kheidi/somatoBot/README.md

# somatoBot
For more information view the [report](somatoBot_Presentation.pdf) and [presentation](somatoBot_Report.pdf).

## How to run
To run main somatobot functions upload the somatoBot project (in home directory) to an Arduino Uno.

Schematic can be found in the systemRequirements folder.

## State Machine Demo
To demonstrate the state machine run the project in the stateMachineDemo folder.

## LCD Test
To test the LCD there is a project in the testLCD file.

## Contact
kfehr@wisc.edu & hernandezher@wisc.edu
