kheidi/somatoBot/Notes_Resorces.md

# Project Notes & Resources
## Debug Wire
Used this website: [https://www.hilltop-cottage.info/blogs/adam/debugging-arduino-using-debugwire-atmel-studio-and-an-avr-dragon/](https://www.hilltop-cottage.info/blogs/adam/debugging-arduino-using-debugwire-atmel-studio-and-an-avr-dragon/)

## Motor Control
### PWM Info
#### AVR Timers
- PWM Mode Part 1: https://maxembedded.wordpress.com/2011/08/07/avr-timers-pwm-mode-part-i/
    - Probably want to use Fast PWM on 8 bit 
    - Suggests non-inverted mode
https://maxembedded.com/2012/01/avr-timers-pwm-mode-part-ii/
- Video tutorial on PWM on Mega328p: https://www.youtube.com/watch?v=_7qujfpKyvw
- Notes on PWM Interrupt Codevision: https://students.iitk.ac.in/eclub/assets/lectures/embedded/Embedded-Old-2.pdf
