kheidi/somatoBot/somatoBot_Presentation.pdf

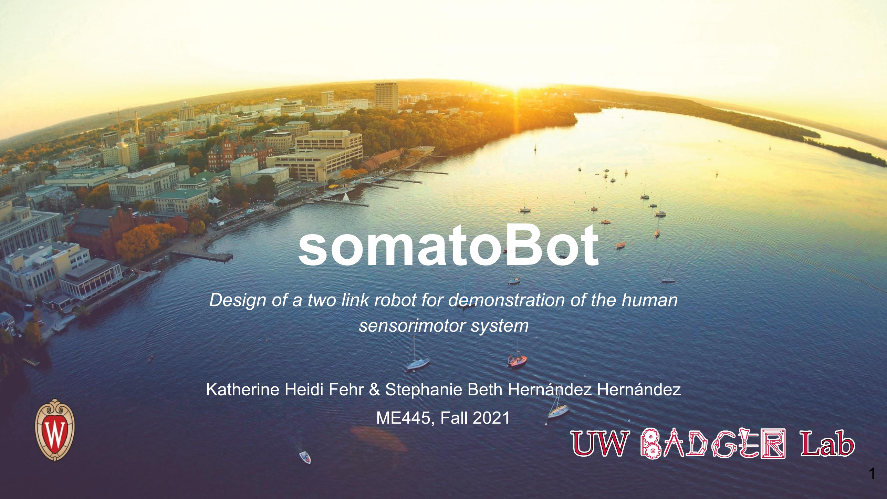
[picture p13: page 1]

# somatoBot

Katherine Heidi Fehr & Stephanie Beth Hernández Hernández

ME445, Fall 2021

Design of a two link robot for demonstration of the human sensorimotor system

## Objective

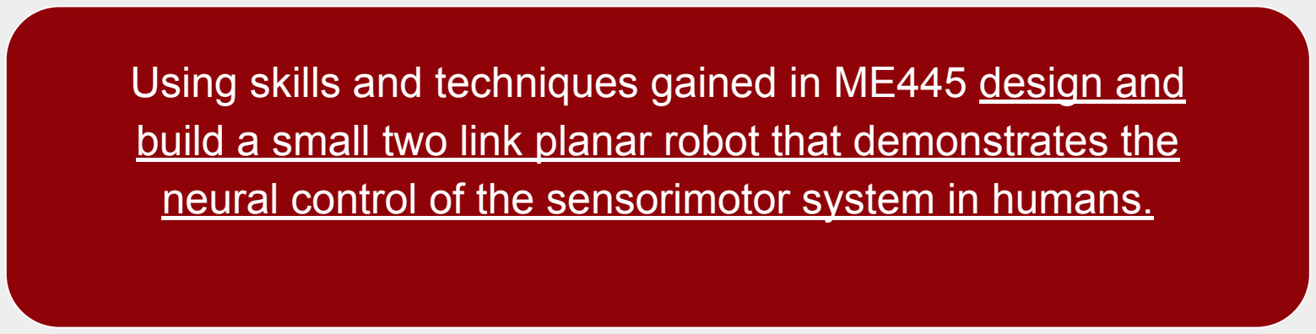
[picture p14: figure]

Using skills and techniques gained in ME445 design and build a small two link planar robot that demonstrates the neural control of the sensorimotor system in humans.

## Sensorimotor = Senses & Motor Movement

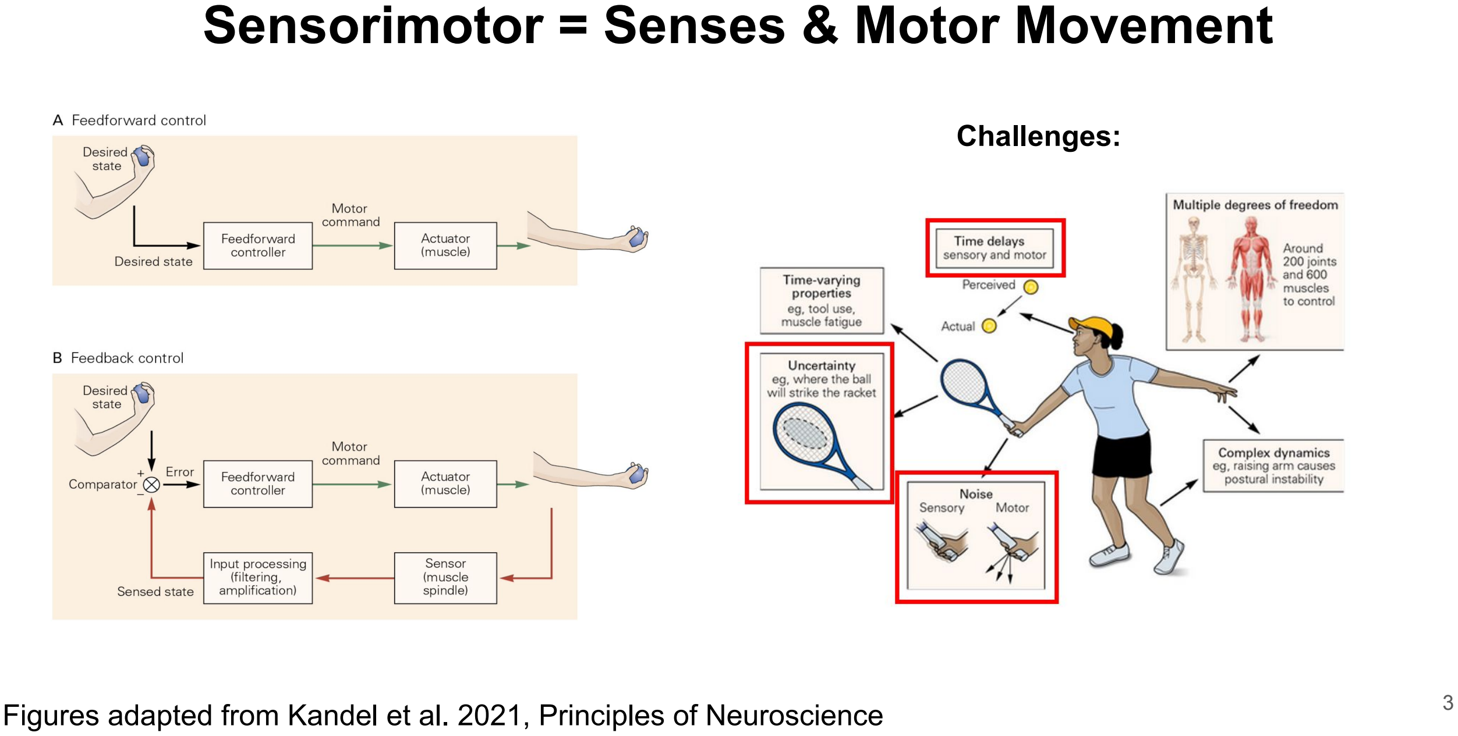
[picture p15: page 3]

Figures adapted from Kandel et al. 2021, Principles of Neuroscience | 3

Challenges:

## Goals

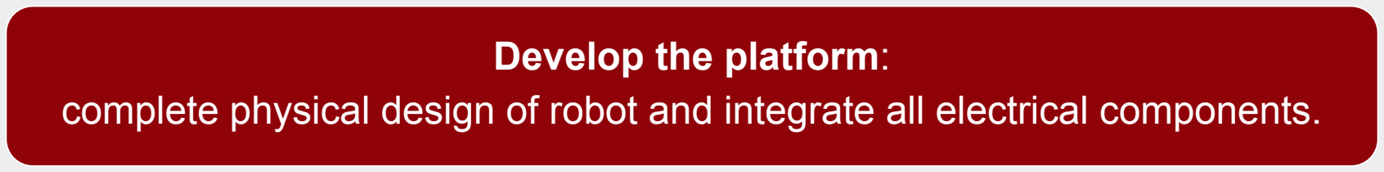
[picture p16: figure]
Develop the platform:

complete physical design of robot and integrate all electrical components.

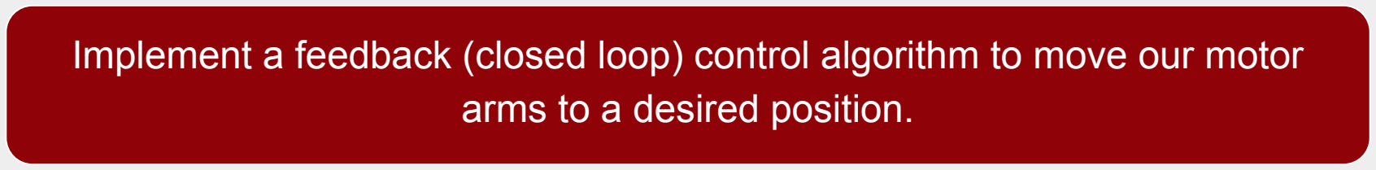
[picture p17: figure]
arms to a desired position.

Implement a feedback (closed loop) control algorithm to move our motor

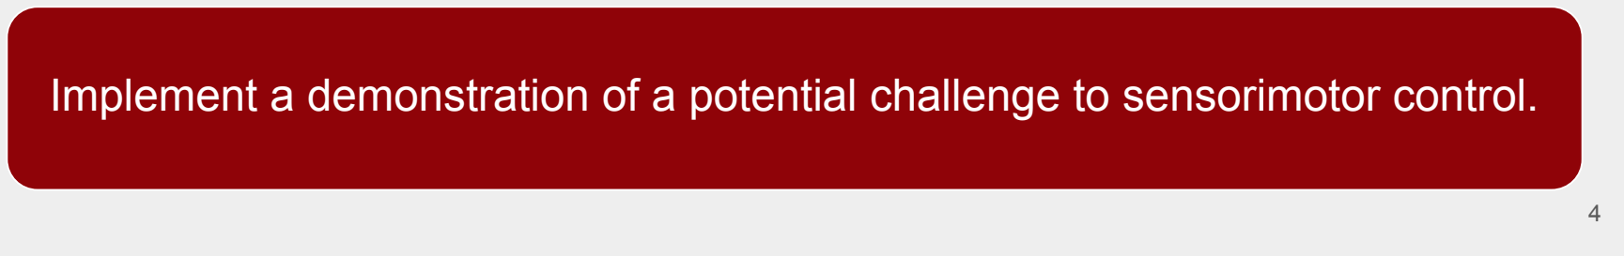
[picture p18: figure]

Implement a demonstration of a potential challenge to sensorimotor control.

## Physical Design

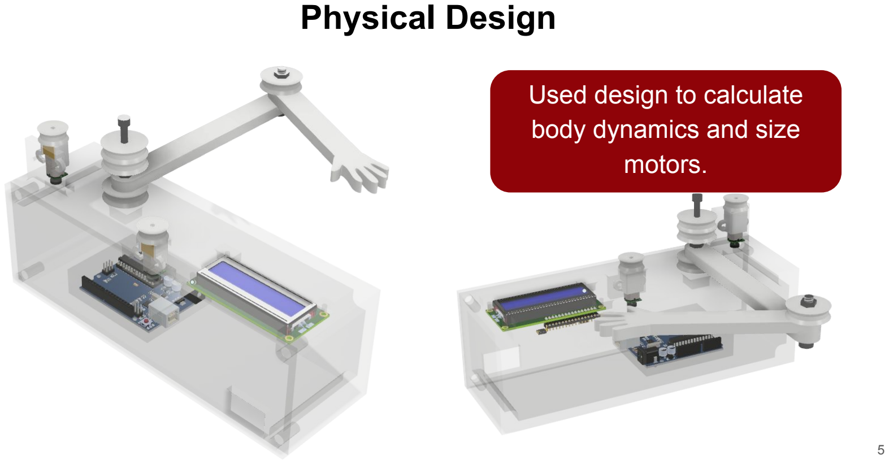
[picture p19: page 5]

Used design to calculate
body dynamics and size
motors.

## Physical Design

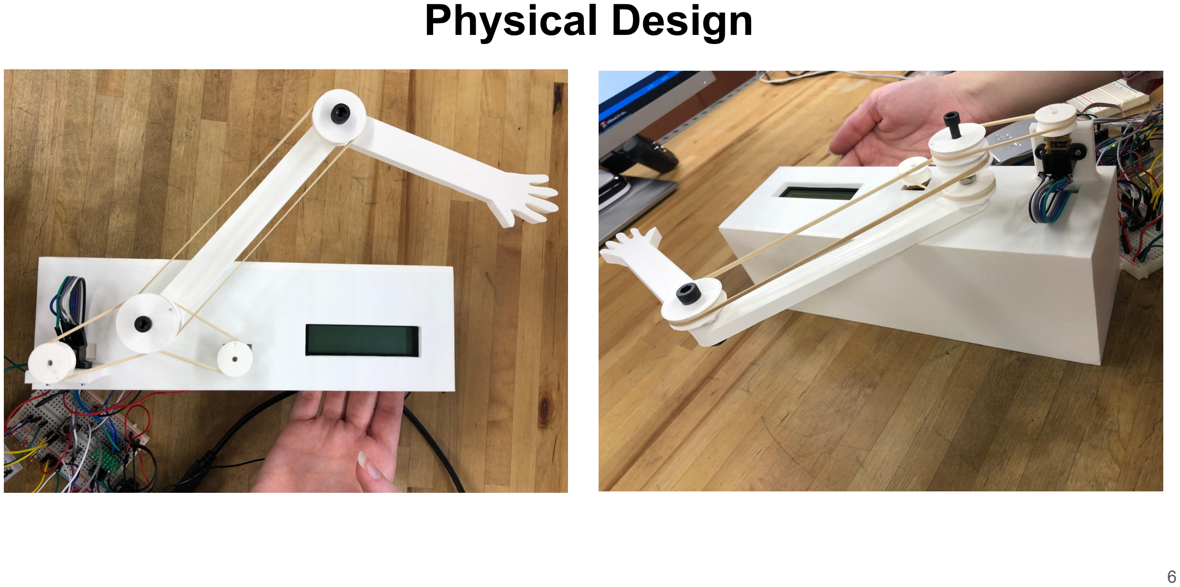
[picture p20: page 6]

## Inverse Kinematics

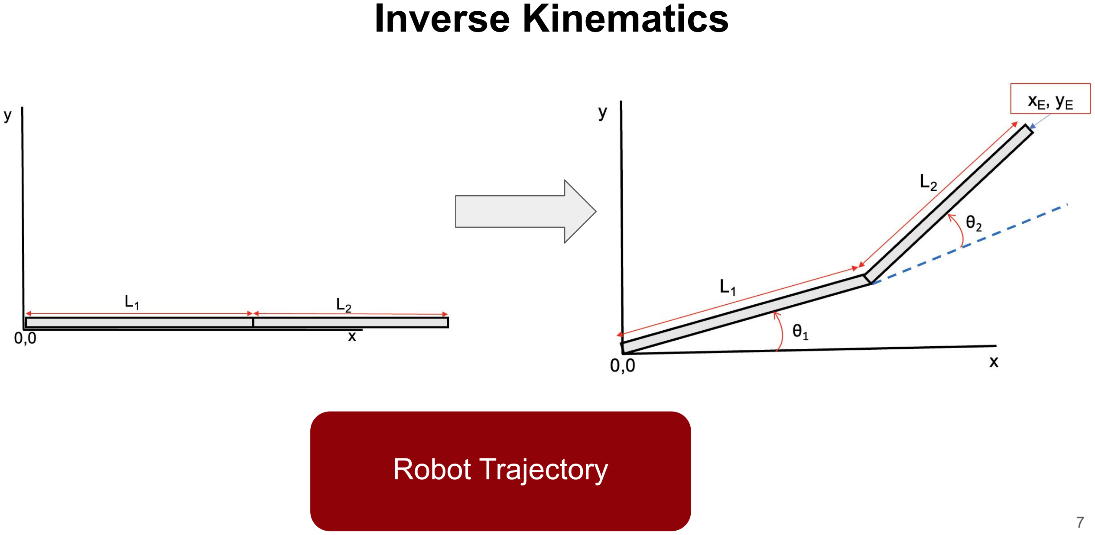
[picture p21: page 7]

Robot Trajectory

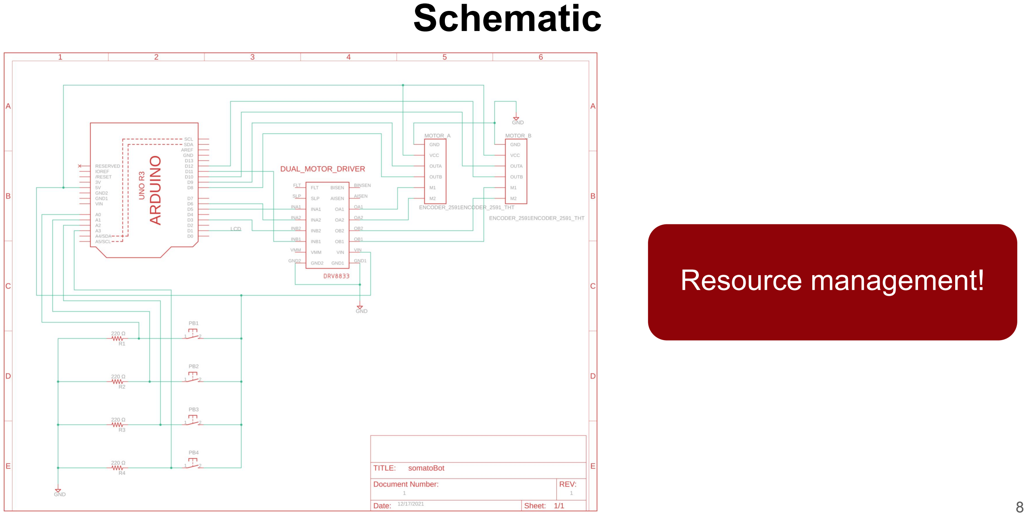
[picture p22: figure]
Schematic; Resource management!

## PWM Motor Control

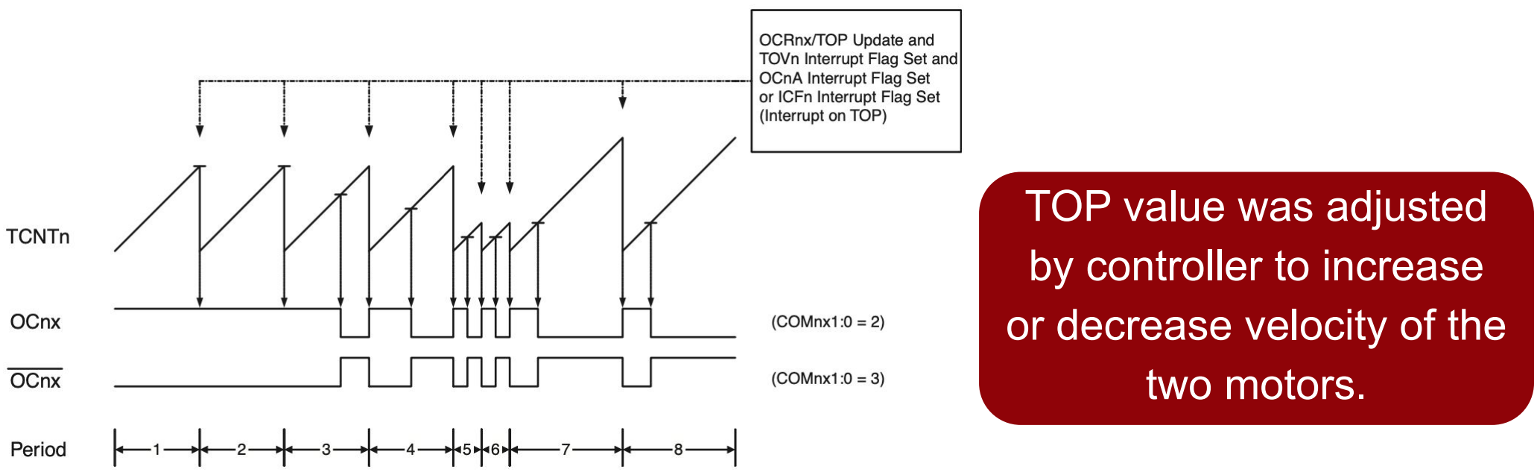
[picture p23: figure]
TOP value was adjusted by controller to increase or decrease velocity of the two motors.

Fast PWM Mode, Timing Diagram
(image from ATMEL ATmega328p data sheet)

## Control Laws

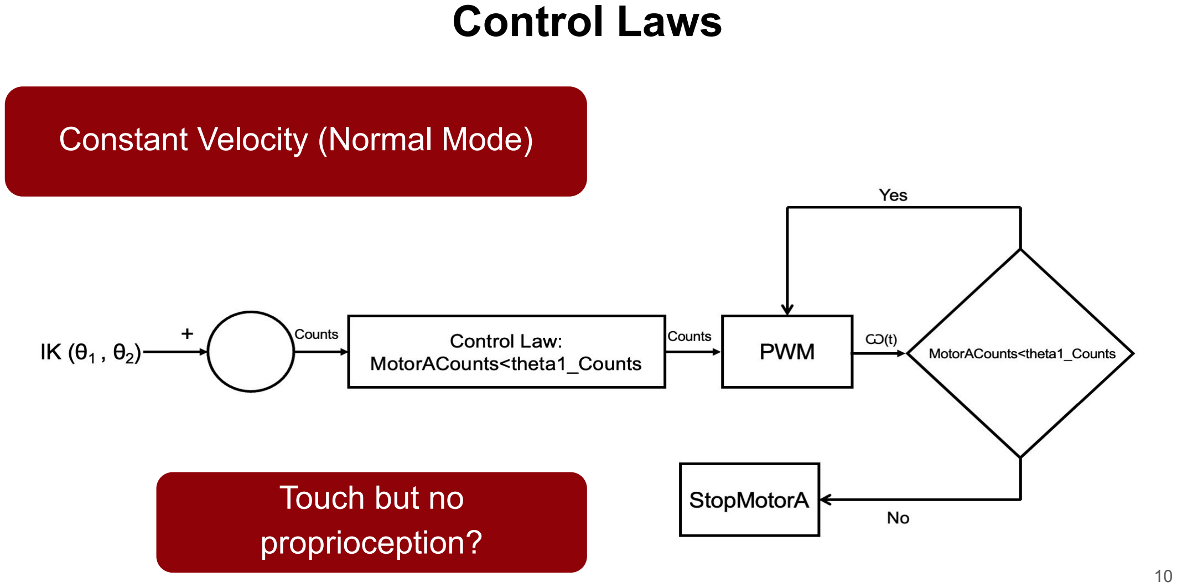
[picture p24: page 10]

Constant Velocity (Normal Mode)

Touch but no
proprioception?

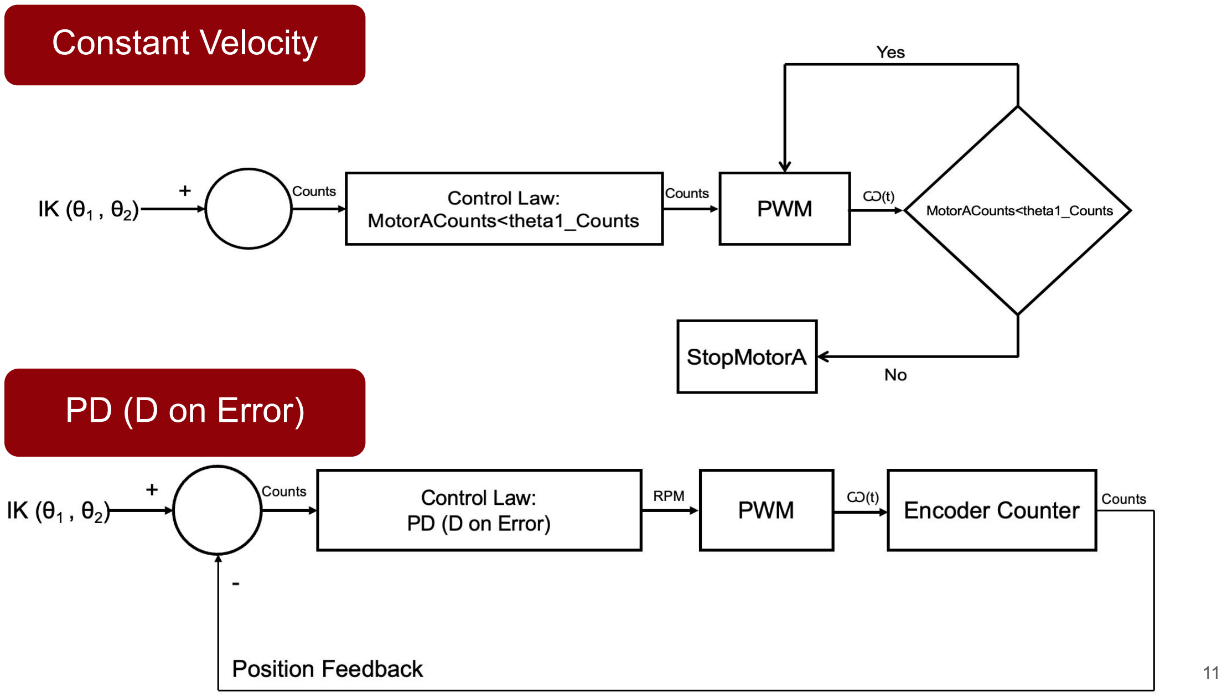
[picture p25: page 11]

PD (D on Error)

Constant Velocity

## State Machine

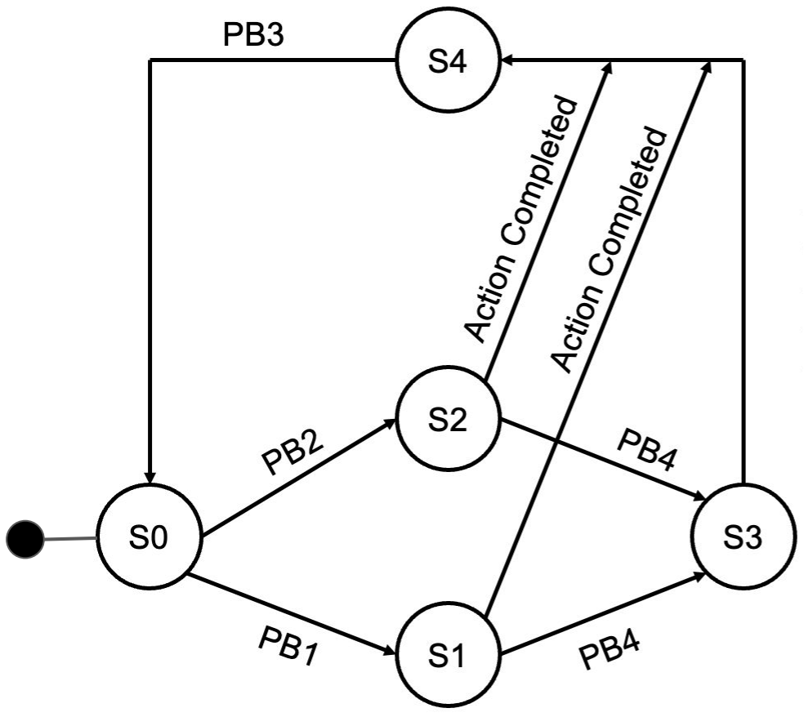
[picture p26: figure]
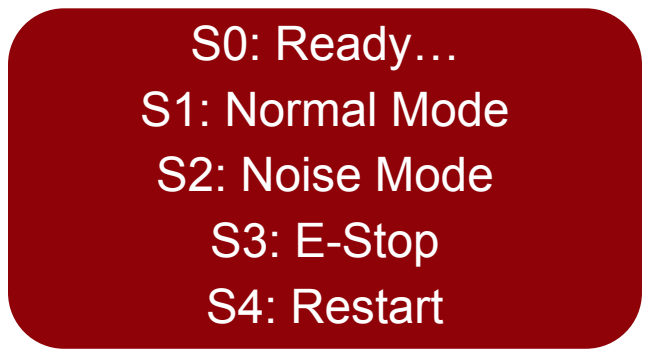
[picture p27: figure]
S0: Ready… S1: Normal Mode S2: Noise Mode S3: E-Stop S4: Restart

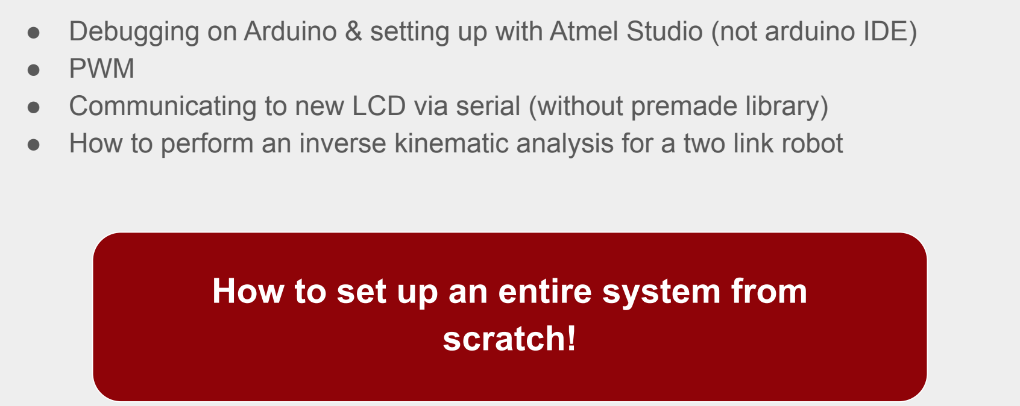
[picture p28: figure]
● PWM; How to set up an entire system from scratch!

- Debugging on Arduino & setting up with Atmel Studio (not arduino IDE)
- Communicating to new LCD via serial (without premade library)
- How to perform an inverse kinematic analysis for a two link robot

## Challenges Overcome

- Refine mechanical design and pulley system
- Replace/Repair LCD
- Resolve conflict between encoder counter and state machine
- Dedicated encoder counter
- Add additional modes with corresponding control laws

## Future Work

- Circuit design
- Data sheet reading
- C programming & debugging with CodeVision AVR and Atmel Studio
- Digital I/O & Digital logic
- Interrupts & timers
- State transition diagrams
- Use of an LCD
- Encoder counting
- PD Control
- Fixed point math
- PWM & H-Bridge

## ME445 Tools/Topics Covered:
