kheidi/somatoBot/InverseKinematics.pdf

y

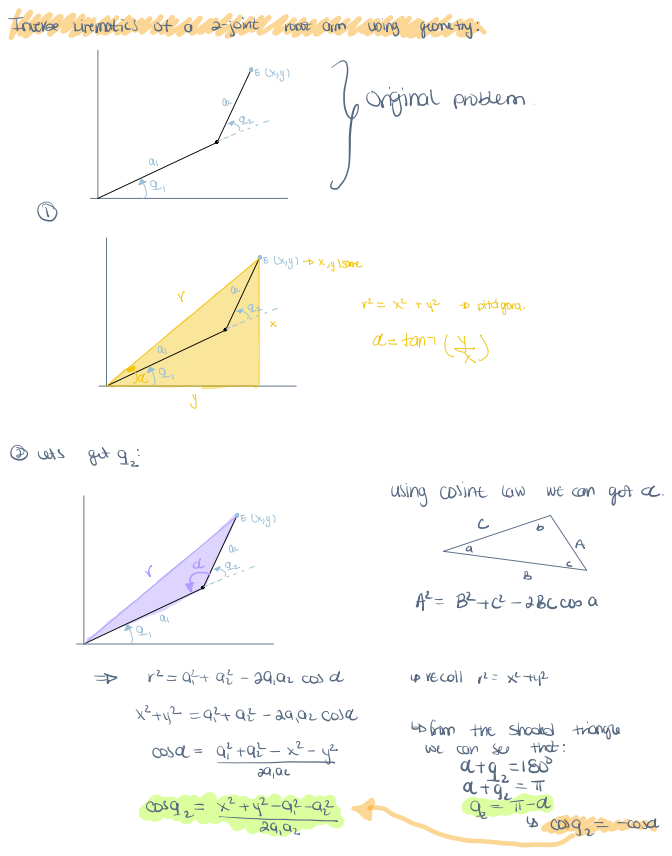
[picture p29: page 1]
Befunctiontakes ix y asinputs; A endeffectorpoints; originalproblem; v2 X ya D pit'agora; a tant; Tata; lets getga; easy; At BTC 2BCosa; aft at 29,92cos d; uprecall re x'tip; x 42 94 95 29,92Cosa; Cosa; aitagxye; Cosas; egg; 95 cog cosa

Inverse kinematics of a 2 joint robotarm using geometry

E xy Dx ylsame

using cosint Law wecan get a

from the shaded triangle
we can see that
9 92 ¹⁸⁰⁰
Atg T

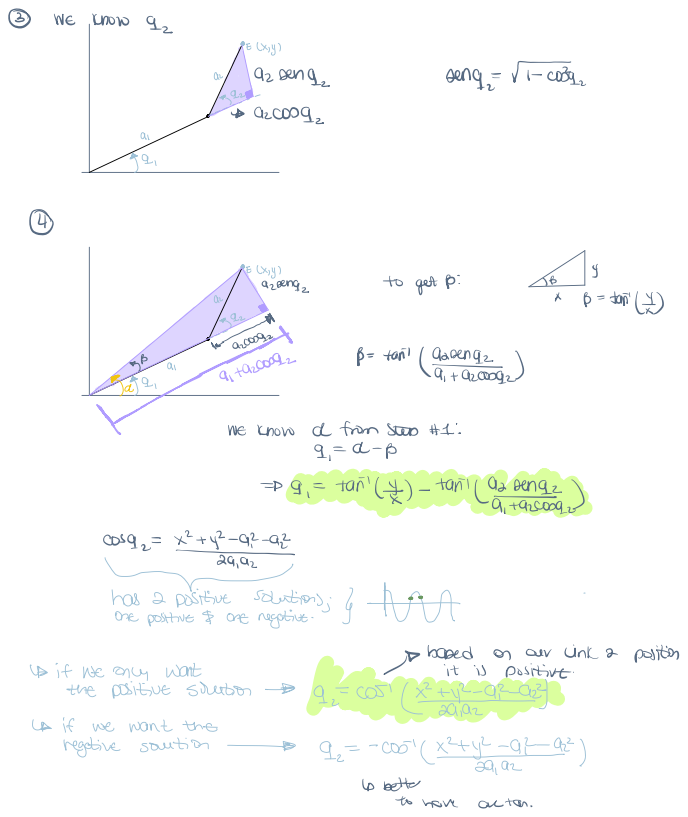
[picture p30: page 2]
We Know 9 2; 92Deng; Seng FA; tobaccosg; EYapping; p tan; ayyy; tan; tan gtfo; ÉPÉE; if we only want; it is positive the positive solution; f tqj; link Positio; negative soution; g Coo Xtyjagic b bettman altar

petar affaire go.int WEknow d fromStets 1

cosge x2 ya at at

if we want the

# tgg.az 9

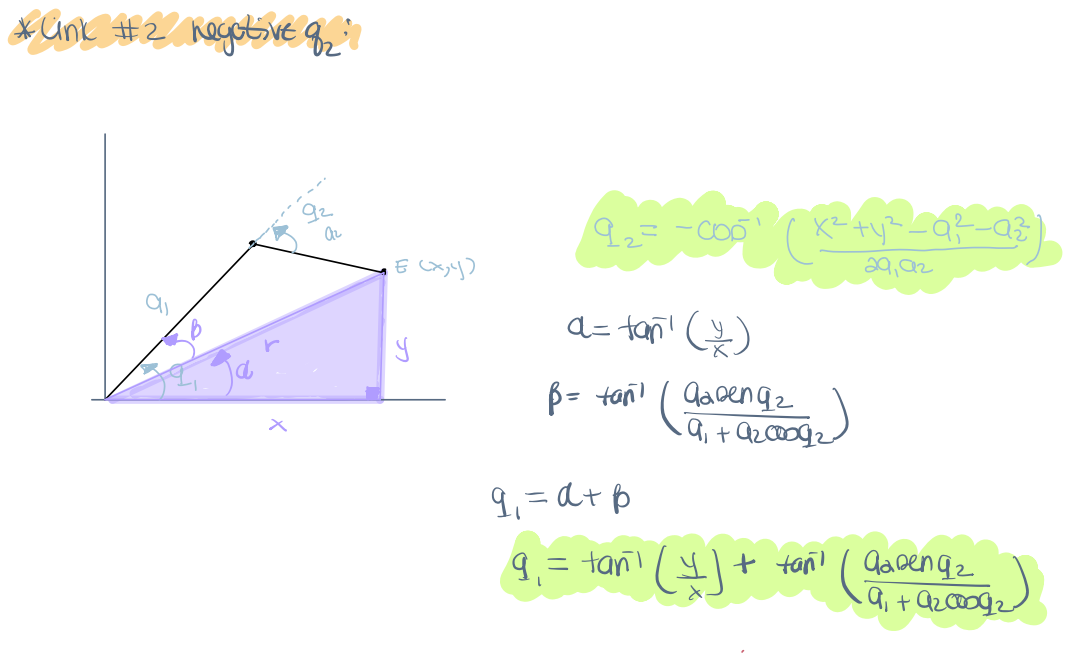
[picture p31: page 3]
link 2 negativeq2; ga Easy; a tan y; Petar 97ft; 9 Atp; g tant; tar

How do I determine it q is negative or positive
Notsure this is the correct approach
Where do I input motor into
