kheidi/somatoBot/PWMDevel/main.c

/*******************************************************
This program was created by the CodeWizardAVR V3.31 
Automatic Program Generator
� Copyright 1998-2017 Pavel Haiduc, HP InfoTech s.r.l.
http://www.hpinfotech.com

Project : PWMDevel - SomatoBot
Version : v1
Date    : 12/4/2021
Author  : Katherine Heidi Fehr
Company : 
Comments: Code to test and develop pwmControl of motors for
          Somatobot project.

Chip type               : ATmega328P
Program type            : Application
AVR Core Clock frequency: 16.000000 MHz
Memory model            : Small
External RAM size       : 0
Data Stack size         : 512
*******************************************************/

/**
 * TODO: Decide if keeping ramp up delay
 * TODO: Measure speed of motor based on encoder at different levels of power
 * TODO: Encoder control?
 */

#include <io.h>
#include <stdlib.h>
#include <delay.h>
#include "pwmControl.h" 
#include "generalFunctions.h"

// Declare your global variables here
int i;

void main(void)
{
// Declare your local variables here
int myTest;
// Crystal Oscillator division factor: 1
#pragma optsize-
CLKPR=(1<<CLKPCE);
CLKPR=(0<<CLKPCE) | (0<<CLKPS3) | (0<<CLKPS2) | (0<<CLKPS1) | (0<<CLKPS0);
#ifdef _OPTIMIZE_SIZE_
#pragma optsize+
#endif

// Input/Output Ports initialization
// Port B initialization
// Function: Bit7=In Bit6=In Bit5=In Bit4=In Bit3=Out Bit2=In Bit1=In Bit0=In 
DDRB=(0<<DDB7) | (0<<DDB6) | (0<<DDB5) | (0<<DDB4) | (1<<DDB3) | (0<<DDB2) | (0<<DDB1) | (0<<DDB0);
// State: Bit7=T Bit6=T Bit5=T Bit4=T Bit3=0 Bit2=T Bit1=T Bit0=T 
PORTB=(0<<PORTB7) | (0<<PORTB6) | (0<<PORTB5) | (0<<PORTB4) | (0<<PORTB3) | (0<<PORTB2) | (0<<PORTB1) | (0<<PORTB0);

// Port C initialization
// Function: Bit6=In Bit5=In Bit4=In Bit3=In Bit2=In Bit1=In Bit0=In 
DDRC=(0<<DDC6) | (0<<DDC5) | (0<<DDC4) | (0<<DDC3) | (0<<DDC2) | (0<<DDC1) | (0<<DDC0);
// State: Bit6=T Bit5=T Bit4=T Bit3=T Bit2=T Bit1=T Bit0=T 
PORTC=(0<<PORTC6) | (0<<PORTC5) | (0<<PORTC4) | (0<<PORTC3) | (0<<PORTC2) | (0<<PORTC1) | (0<<PORTC0);

// Port D initialization
// Function: Bit7=In Bit6=Out Bit5=Out Bit4=In Bit3=Out Bit2=In Bit1=In Bit0=In 
DDRD=(0<<DDD7) | (1<<DDD6) | (1<<DDD5) | (0<<DDD4) | (1<<DDD3) | (0<<DDD2) | (0<<DDD1) | (0<<DDD0);
// State: Bit7=T Bit6=0 Bit5=0 Bit4=T Bit3=0 Bit2=T Bit1=T Bit0=T 
PORTD=(0<<PORTD7) | (0<<PORTD6) | (0<<PORTD5) | (0<<PORTD4) | (0<<PORTD3) | (0<<PORTD2) | (0<<PORTD1) | (0<<PORTD0);

// Timer/Counter 0 initialization
// Clock source: System Clock
// Clock value: 16000.000 kHz
// Mode: Fast PWM top=0xFF
// OC0A output: Non-Inverted PWM
// OC0B output: Non-Inverted PWM
// Timer Period: 0.016 ms
// Output Pulse(s):
// OC0A Period: 0.016 ms Width: 0 us
// OC0B Period: 0.016 ms Width: 0 us
pwm_init_timer0_A();

// Timer/Counter 1 initialization
// Clock source: System Clock
// Clock value: Timer1 Stopped
// Mode: Normal top=0xFFFF
// OC1A output: Disconnected
// OC1B output: Disconnected
// Noise Canceler: Off
// Input Capture on Falling Edge
// Timer1 Overflow Interrupt: Off
// Input Capture Interrupt: Off
// Compare A Match Interrupt: Off
// Compare B Match Interrupt: Off
TCCR1A=(0<<COM1A1) | (0<<COM1A0) | (0<<COM1B1) | (0<<COM1B0) | (0<<WGM11) | (0<<WGM10);
TCCR1B=(0<<ICNC1) | (0<<ICES1) | (0<<WGM13) | (0<<WGM12) | (0<<CS12) | (0<<CS11) | (0<<CS10);
TCNT1H=0x00;
TCNT1L=0x00;
ICR1H=0x00;
ICR1L=0x00;
OCR1AH=0x00;
OCR1AL=0x00;
OCR1BH=0x00;
OCR1BL=0x00;

// Timer/Counter 2 initialization
// Clock source: System Clock
// Clock value: 16000.000 kHz
// Mode: Fast PWM top=0xFF
// OC2A output: Non-Inverted PWM
// OC2B output: Non-Inverted PWM
// Timer Period: 0.016 ms
// Output Pulse(s):
// OC2A Period: 0.016 ms Width: 0 ms
// OC2B Period: 0.016 ms Width: 0 us
pwm_init_timer2_B();

// Timer/Counter 0 Interrupt(s) initialization
TIMSK0=(0<<OCIE0B) | (0<<OCIE0A) | (0<<TOIE0);

// Timer/Counter 1 Interrupt(s) initialization
TIMSK1=(0<<ICIE1) | (0<<OCIE1B) | (0<<OCIE1A) | (0<<TOIE1);

// Timer/Counter 2 Interrupt(s) initialization
TIMSK2=(0<<OCIE2B) | (0<<OCIE2A) | (0<<TOIE2);

// External Interrupt(s) initialization
// INT0: Off
// INT1: Off
// Interrupt on any change on pins PCINT0-7: Off
// Interrupt on any change on pins PCINT8-14: Off
// Interrupt on any change on pins PCINT16-23: Off
PCINT_Encoder_init();

// USART initialization
// USART disabled
UCSR0B=(0<<RXCIE0) | (0<<TXCIE0) | (0<<UDRIE0) | (0<<RXEN0) | (0<<TXEN0) | (0<<UCSZ02) | (0<<RXB80) | (0<<TXB80);

// Analog Comparator initialization
// Analog Comparator: Off
// The Analog Comparator's positive input is
// connected to the AIN0 pin
// The Analog Comparator's negative input is
// connected to the AIN1 pin
ACSR=(1<<ACD) | (0<<ACBG) | (0<<ACO) | (0<<ACI) | (0<<ACIE) | (0<<ACIC) | (0<<ACIS1) | (0<<ACIS0);
ADCSRB=(0<<ACME);
// Digital input buffer on AIN0: On
// Digital input buffer on AIN1: On
DIDR1=(0<<AIN0D) | (0<<AIN1D);

// ADC initialization
// ADC disabled
ADCSRA=(0<<ADEN) | (0<<ADSC) | (0<<ADATE) | (0<<ADIF) | (0<<ADIE) | (0<<ADPS2) | (0<<ADPS1) | (0<<ADPS0);

// SPI initialization
// SPI disabled
SPCR=(0<<SPIE) | (0<<SPE) | (0<<DORD) | (0<<MSTR) | (0<<CPOL) | (0<<CPHA) | (0<<SPR1) | (0<<SPR0);

// TWI initialization
// TWI disabled
TWCR=(0<<TWEA) | (0<<TWSTA) | (0<<TWSTO) | (0<<TWEN) | (0<<TWIE);

myTest = map(5,0,100,0,200);

//Test run motor code


while (1)
      {
      // Place your code here

// 		runMotor(0, MOTOR_A, CCW);
// 		delay_us(1000000);
// 		runMotor(25, MOTOR_A, CCW);
// 		delay_us(1000000);
// 		runMotor(50, MOTOR_A, CCW);
// 		delay_us(1000000);

// 		runMotor(60, MOTOR_A, CCW);
// 		delay_us(1000000);
// 		runMotor(60, MOTOR_A, CW);
// 		delay_us(1000000);
// 		runMotor(70, MOTOR_A, CCW);
// 		delay_us(1000000);
// 		runMotor(70, MOTOR_A, CW);
// 		delay_us(1000000);
// 		runMotor(80, MOTOR_A, CCW);
// 		delay_us(1000000);
// 		runMotor(80, MOTOR_A, CW);
// 		delay_us(1000000);
// 		runMotor(90, MOTOR_A, CCW);
// 		delay_us(1000000);
// 		runMotor(90, MOTOR_A, CW);
// 		delay_us(1000000);
// 		runMotor(100, MOTOR_A, CCW);
// 		delay_us(1000000);
// 		runMotor(100, MOTOR_A, CW);
// 		delay_us(1000000);

// 		runMotor(25, MOTOR_A, CW);
// 		delay_us(1000000);
// 		runMotor(50, MOTOR_A, CW);
// 		delay_us(1000000);
		runMotor(100, MOTOR_A, CW);
		runMotor(0, MOTOR_B, CW);
		//delay_us(1000000);


      }
}
