kheidi/somatoBot/(commit log)

2021-11-19 Initial torque estimate with smaller arms design from 11/16/21
2021-11-21 Updated CAD, longer arms
2021-11-22 added encoder counter code which includes handling pulse updates with a PCInterrupt, and communication to a host device over SPI
2021-12-04 Updated CAD
2021-12-04 Initial, sets up PWM timers & ports
2021-12-05 Creates project to test PWM functions, compiles, not yet tested with hardware
2021-12-05 PWM test project files, not tested
2021-12-07 Motors run, motor A runs fine, motor B runs a little when the program is run and then when it is ended.
2021-12-07 Adds encoder counter, not tested or compiled.
2021-12-09 Sample code for PCINT
2021-12-12 Creates main somatoBot project compiles, issue with encoder.
    [generalFunctions.h, main.c, pwmControl.c, pwmControl.h]
2021-12-13 Modifies motor B encoder pins, not sure if functional
2021-12-13 Motor runs, encoder counts
2021-12-13 Modified MotorContro and main to move the motor using encoder counts.
2021-12-13 Position control compiles, still buggy
    [main.c, pwmControl.c, pwmControl.h]
2021-12-15 Tries (unsuccessfully) to fix LCD
    [main.c]
2021-12-16 Trying to debug motor control
2021-12-16 State Machine for buttons
2021-12-16 Updated Equation for Inverse Kinematic. Simple Matlab test
2021-12-16 Total mess, failed state machine and encoder counter combo
    [StateMachine.c, StateMachine.h, Trajectory.c, Trajectory.h, main.c]
2021-12-17 State machine, may be missing adjustments from other files
    [main.c]
